deSales327/corne-pg1316s/keycaps/step/mikeholscher_PG1316S_keycap_normal.step

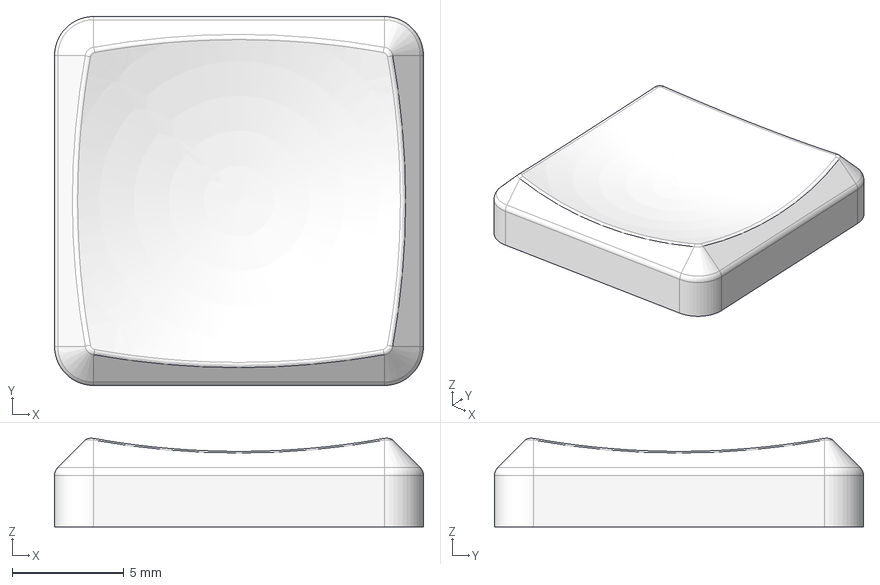
[picture p5: CAD file, 2026-11-02]
keycaps/step/mikeholscher_PG1316S_keycap_normal.step
16.5 x 16.5 x 3.96 mm
