deSales327/corne-pg1316s/keycaps/step/mikeholscher_PG1316S_keycap_keywellangled.step

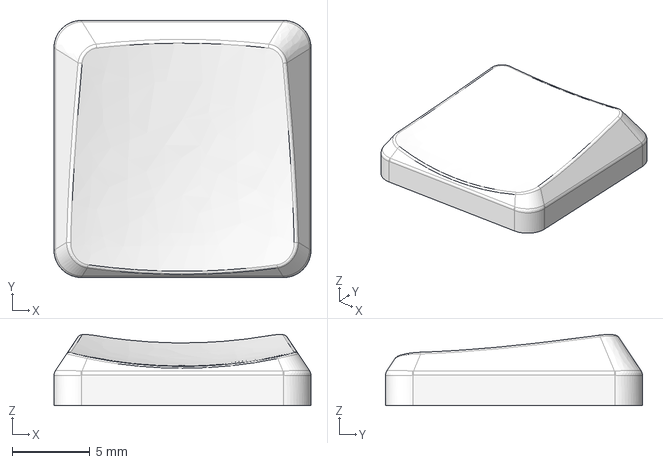
[picture p6: CAD file, 2026-11-02]
keycaps/step/mikeholscher_PG1316S_keycap_keywellangled.step
16.5 x 16.5 x 4.56 mm
