deSales327/corne-pg1316s/keycaps/step/mikeholscher_PG1316S_keycap_keywellcenter.step

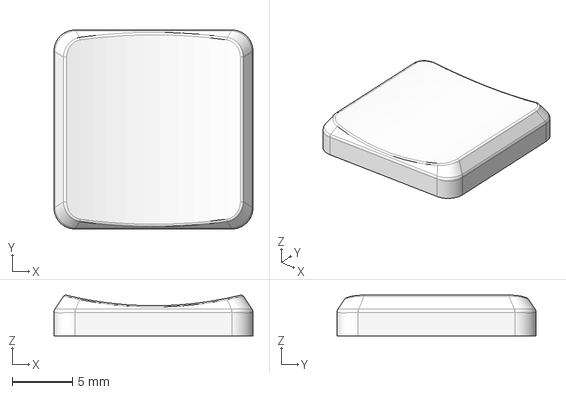
[picture p7: CAD file, 2026-11-02]
keycaps/step/mikeholscher_PG1316S_keycap_keywellcenter.step
16.5 x 16.5 x 3.38 mm
