deSales327/corne-pg1316s/(list of files, cad)

Other CAD files:
keycaps/step/mikeholscher_PG1316S_keycap_normalthumb.step
keycaps/stl/mikeholscher_PG1316S_keycap_keywellangled.stl
keycaps/stl/mikeholscher_PG1316S_keycap_keywellcenter.stl
keycaps/stl/mikeholscher_PG1316S_keycap_normal.stl
keycaps/stl/mikeholscher_PG1316S_keycap_normalthumb.stl
