deSales327/corne-pg1316s/corne-pg1316s.kicad_pcb

## KiCad design corne-pg1316s.kicad_pcb (2026-11-03)

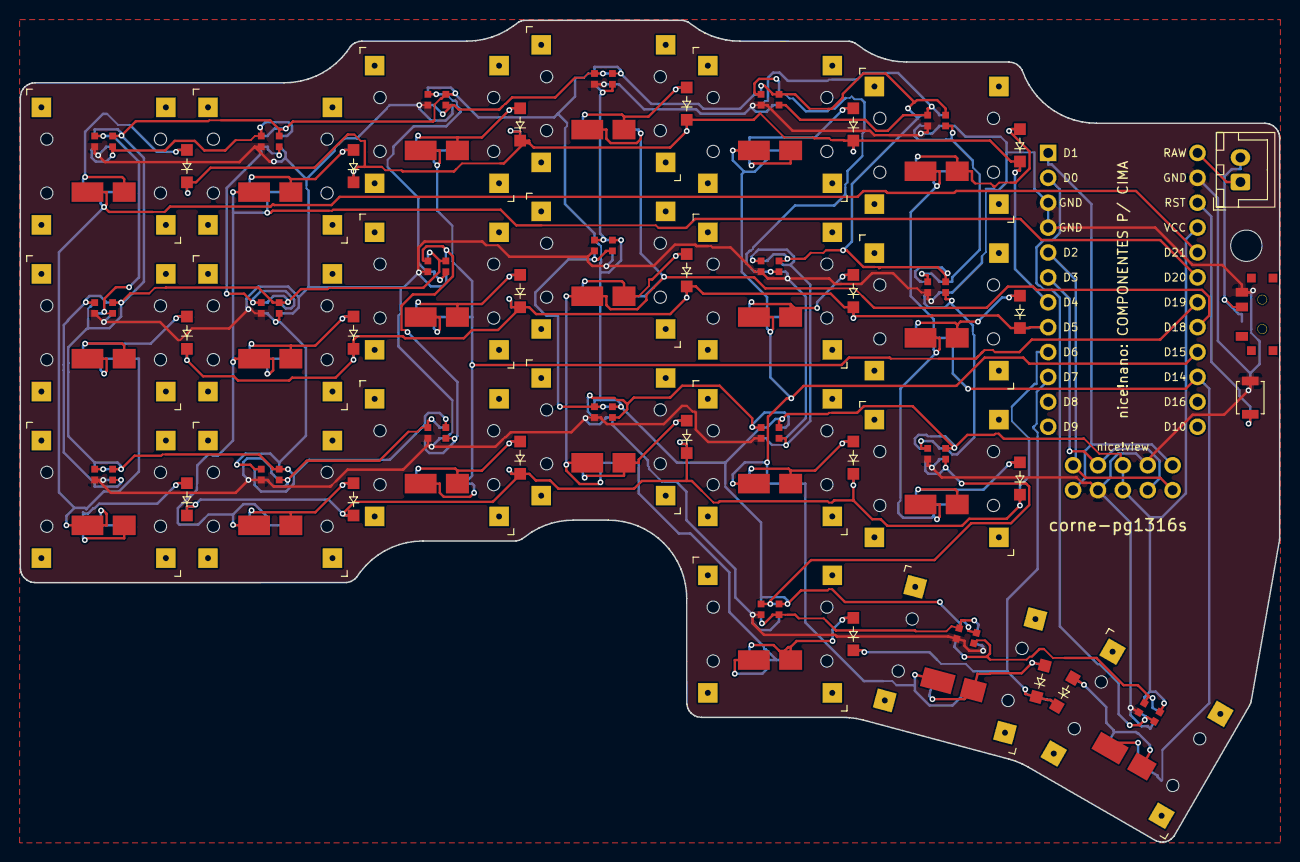
[picture p8: board corne-pg1316s.kicad_pcb from above]

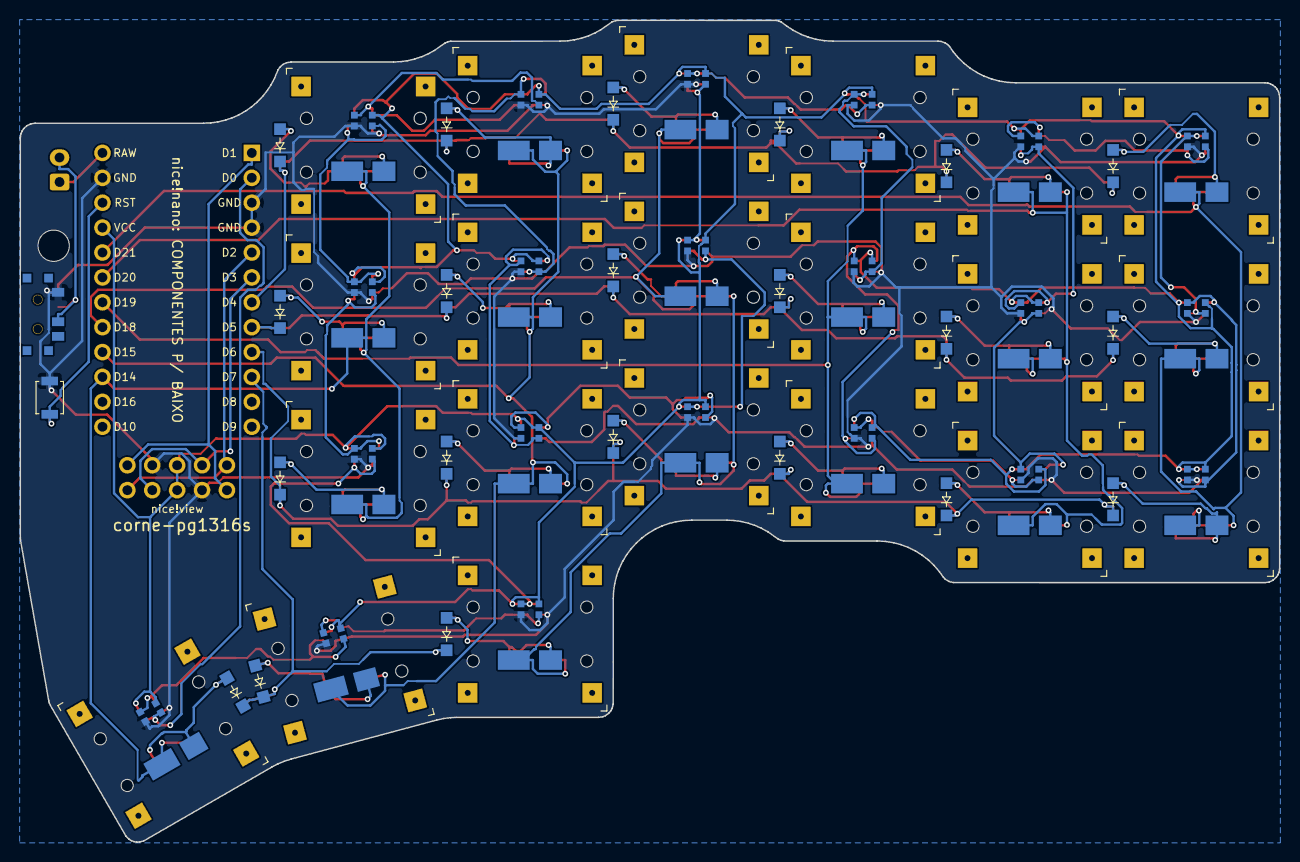
[picture p9: board corne-pg1316s.kicad_pcb from below]

Board: 2 copper layers, 128.5 x 83.9 mm, 71 parts (2 on the bottom side), 60 nets.

Parts:
D1, D2, D3, D4, D5, D6, D7, D8, D9, D10, D11, D12, D13, D14, D15, D16, D17, D18, D19, D20, D21: ComboDiode
DISP1: nice_view_reversible
H1: MountingHole_3.2mm_M3
J1: JST_XH_B2B-XH-A_1x02_P2.50mm_Vertical
L1, L2, L3, L4, L5, L6, L7, L8, L9, L10, L11, L12, L13, L14, L15, L16, L17, L18, L19, L20, L21: WS2812B-2020; WS2812B-2020_reversible
MCU1: ProMicro_reversible
PWR1, PWR1#2: SPDT_C128955
RST1, RST2: SW_SPST_B3U-1000P
S1, S2, S3, S4, S5, S6, S7, S8, S9, S10, S11, S12, S13, S14, S15, S16, S17, S18, S19, S20, S21: PG1316S; Kailh_PG1316S_reversible

Connections:
BAT: J1.1, MCU1.13
BAT-: J1.2, PWR1.2, PWR1#2.2
GND: DISP1.4, DISP1.7, L1.2, L2.2, L3.2, L4.2, L5.2, L6.2, L7.2, L8.2, L9.2, L10.2, L11.2, L12.2, L13.2, L14.2, L15.2, L16.2, L17.2, L18.2, L19.2, L20.2, L21.2, MCU1.3, MCU1.4, MCU1.14, PWR1.3, PWR1#2.1, RST1.2, RST2.2
RST: MCU1.15, RST1.1, RST2.1
VCC: DISP1.3, DISP1.8, L1.4, L2.4, L3.4, L4.4, L5.4, L6.4, L7.4, L8.4, L9.4, L10.4, L11.4, L12.4, L13.4, L14.4, L15.4, L16.4, L17.4, L18.4, L19.4, L20.4, L21.4, MCU1.16
c0: MCU1.17, S1.1, S2.1, S3.1
c1: MCU1.18, S4.1, S5.1, S6.1
c2: MCU1.19, S7.1, S8.1, S9.1
c3: MCU1.20, S10.1, S11.1, S12.1, S19.1
c4: MCU1.21, S13.1, S14.1, S15.1, S20.1
c5: MCU1.22, S16.1, S17.1, S18.1, S21.1
k_c0_r1: D3.2, S3.2
k_c0_r2: D2.2, S2.2
k_c0_r3: D1.2, S1.2
k_c1_r1: D6.2, S6.2
k_c1_r2: D5.2, S5.2
k_c1_r3: D4.2, S4.2
k_c2_r1: D9.2, S9.2
k_c2_r2: D8.2, S8.2
k_c2_r3: D7.2, S7.2
k_c3_r0: D19.2, S19.2
k_c3_r1: D12.2, S12.2
k_c3_r2: D11.2, S11.2
k_c3_r3: D10.2, S10.2
k_c4_r0: D20.2, S20.2
k_c4_r1: D15.2, S15.2
k_c4_r2: D14.2, S14.2
k_c4_r3: D13.2, S13.2
k_c5_r0: D21.2, S21.2
k_c5_r1: D18.2, S18.2
k_c5_r2: D17.2, S17.2
k_c5_r3: D16.2, S16.2
nv_cs: DISP1.5, DISP1.6, MCU1.1
nv_mosi: DISP1.1, DISP1.10, MCU1.5
nv_sck: DISP1.2, DISP1.9, MCU1.6
r0: D19.1, D20.1, D21.1, MCU1.10
r1: D3.1, D6.1, D9.1, D12.1, D15.1, D18.1, MCU1.9
r2: D2.1, D5.1, D8.1, D11.1, D14.1, D17.1, MCU1.8
r3: D1.1, D4.1, D7.1, D10.1, D13.1, D16.1, MCU1.7
rgb0: L21.3, MCU1.2
rgb1: L20.3, L21.1
rgb2: L19.3, L20.1
rgb3: L18.3, L19.1
rgb4: L17.3, L18.1
rgb5: L16.3, L17.1
rgb6: L13.3, L16.1
rgb7: L13.1, L14.3
rgb8: L14.1, L15.3
rgb9: L12.3, L15.1
rgb10: L11.3, L12.1
rgb11: L10.3, L11.1
rgb12: L7.3, L10.1
rgb13: L7.1, L8.3
rgb14: L8.1, L9.3
rgb15: L6.3, L9.1
rgb16: L5.3, L6.1
rgb17: L4.3, L5.1
rgb18: L1.3, L4.1
rgb19: L1.1, L2.3
rgb20: L2.1, L3.3
