deSales327/corne-pg1316s/(commit log)

2026-11-02 corne-pg1316s: Corne sem fios para switches Kailh PG1316S
    PCB reversível 3x6+3 (42 teclas) com footprint PG1316S desenhado a
    partir da ficha técnica da Kailh, díodos na cavidade do switch,
    XIAO nRF52840, JST-XH e furo para a bateria. Roteada com o
    Freerouting, DRC limpo no KiCad 10, gerbers incluídos. Keycaps do
    mikefive (Mike Holscher) em STEP e STL, e mockup montado.
    [corne-pg1316s.kicad_pcb, mikeholscher_PG1316S_keycap_keywellangled.step, mikeholscher_PG1316S_keycap_keywellangled.stl, mikeholscher_PG1316S_keycap_keywellcenter.step, mikeholscher_PG1316S_keycap_keywellcenter.stl, mikeholscher_PG1316S_keycap_normal.step, mikeholscher_PG1316S_keycap_normal.stl, mikeholscher_PG1316S_keycap_normalthumb.step]
2026-11-02 v0.2: corrige a posição dos contactos do switch PG1316S
    Os pads de contacto passam de x = ±2,5 mm para x = -0,5 e +1,7 mm
    (espelhados no verso), confirmados com o footprint testado do
    Delta Omega rev4 e com o reversível do mikefive. Placa voltada a
    rotear: DRC com 0 violações e 0 ligações em falta, gerbers e
    renders atualizados.
    [corne-pg1316s.kicad_pcb]
2026-11-03 v0.3: pads de contacto do PG1316S largos, cobrem as duas posições testadas
    Os footprints fabricados do mikefive/ULK (x = ±2,5 mm) e do Delta Omega
    (x = -0,5/+1,7 mm) usam posições diferentes; os pads agora cobrem ambas.
    [corne-pg1316s.kicad_pcb]
2026-11-03 v0.4: LED RGB por tecla (WS2812B-2020) e interruptor dos LEDs
    - LED na cavidade do switch (janela de LED da ficha técnica), pads nas duas faces
    - díodos passam para o intervalo entre colunas, na face de baixo
    - RGB1: segundo interruptor, liga BAT+ ao VLED
    - D6 do XIAO passa a dados dos LEDs; README com BOM, soldadura e config ZMK
    [corne-pg1316s.kicad_pcb]
2026-11-03 v0.5: nice!nano (Pro Micro nRF52840) + nice!view no lugar do XIAO
    - Pro Micro reversível sem pontes (controlador virado para baixo na metade invertida),
    pinagem igual à do Corne do ZMK (shields corne_left/right + nice_view_adapter)
    - duas filas de furos para o nice!view (uma por face)
    - LEDs no VCC do nice!nano (cortado pelo P0.13): o interruptor RGB1 saiu
    - botão de reset B3U nas duas faces; JST, furo e interruptor na borda direita
    - mockup com nice!view e keycaps transparentes iluminadas; README atualizado
    [corne-pg1316s.kicad_pcb]
